tinyfpga/TinyFPGA-BX/TinyFPGA BX Card Back.png

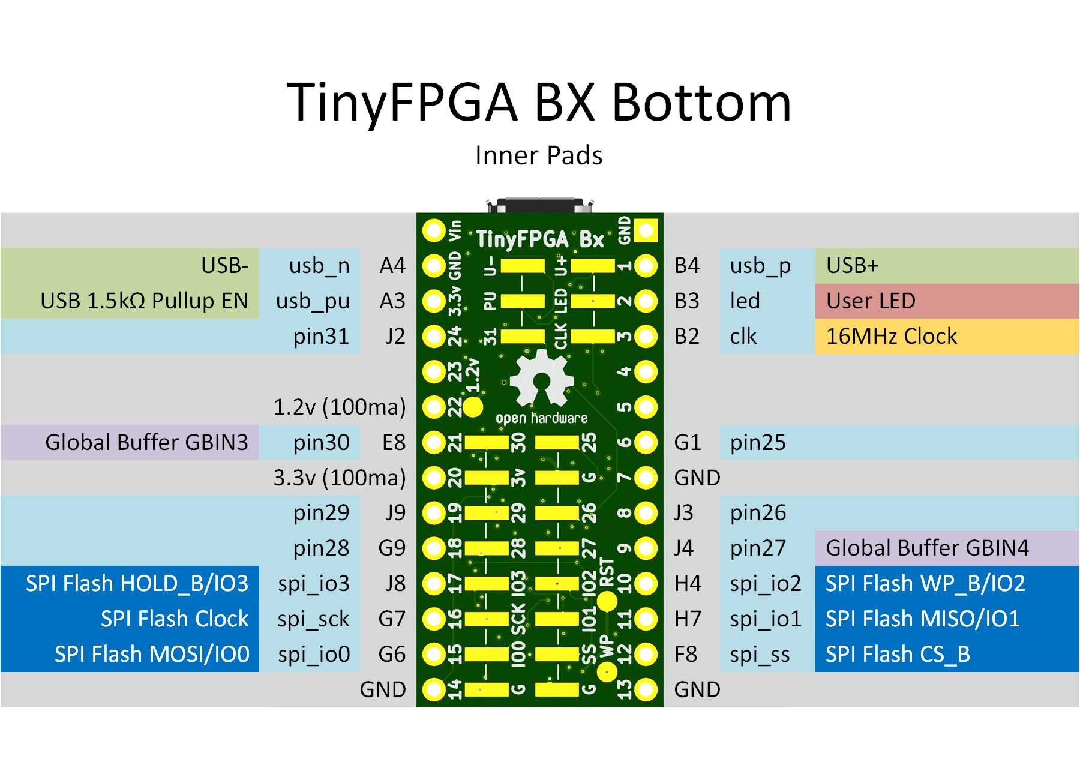
TinyFPGA BX Card Back.png
