tinyfpga/TinyFPGA-BX/TinyFPGA BX Card Front.png

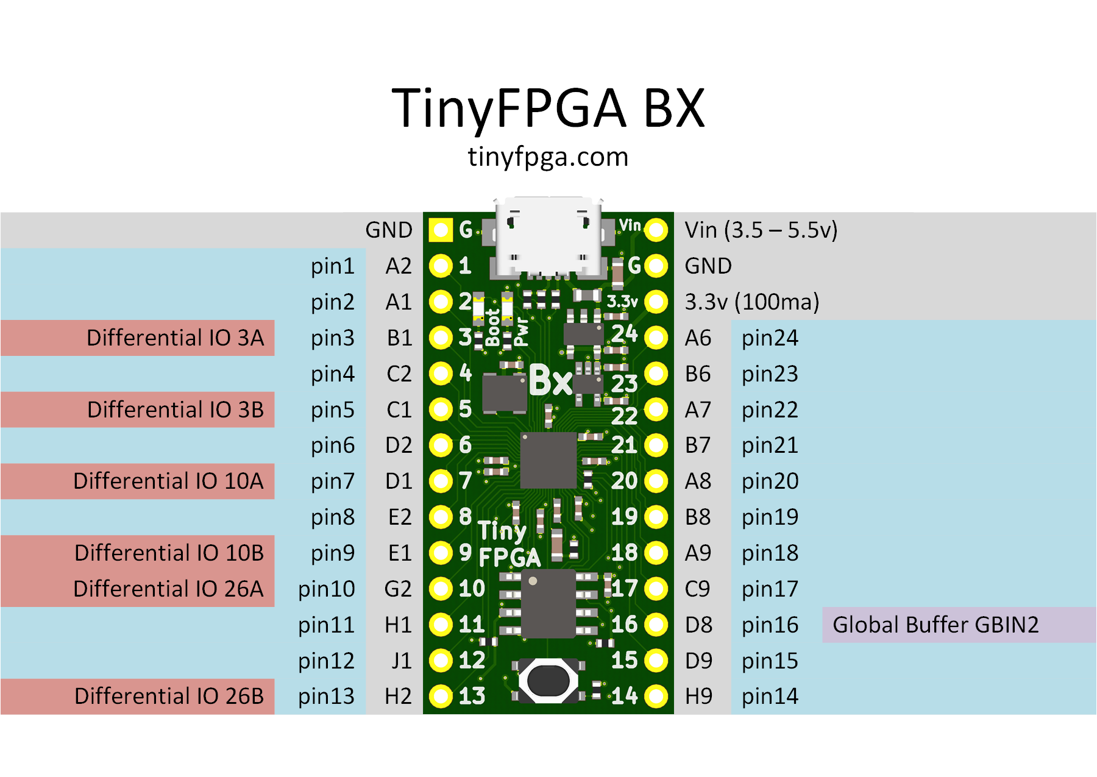
TinyFPGA BX Card Front.png
