tinyfpga/TinyFPGA-BX/(threads)

Thread 2 (2018-07-14):

Error: the JSON object must be str, not 'bytes'

gudenau, 2018-07-14:
I followed the dirrections here to try and program a TinyFPGA BX that I just got and when I get to the upload step it errors with `Error: the JSON object must be str, not 'bytes'`. I guess this is some random Python issue?

What happened:
Uploading the example project errors out with `Error: the JSON object must be str, not 'bytes'`

What should happen:
The project should upload and the FPGA should run it.

Platform:
`uname -a` : `Linux DESKTOP-DEBIAN 4.9.0-6-amd64 #1 SMP Debian 4.9.88-1+deb9u1 (2018-05-07) x86_64 GNU/Linux`

Steps to reproduce: (or what I did)
`sudo apt-get install python3-pip`
`sudo pip3 install --upgrade --no-cache-dir apio==0.4.0b3 "tinyprog>=1.0.9"`
`apio install system scons icestorm iverilog` (since drivers does not exist)
`apio drivers --serial-enable`
`tinyprog --update-bootloader`
Download atom-amd64.deb
`sudo dpkg -i atom-amd64.deb`
Install `apio-ide` in atom.
`git clone https://github.com/tinyfpga/TinyFPGA-BX.git`
`cp TinyFPGA-BX/apio_template blink_project`
Open `blink_project` with `atom`.
Upload.
Error happens here.

tinyfpga, 2018-07-15:
What's the exact version of python are you using?

Update `tinyprog` to 1.0.10:

```shell
sudo pip3 install --upgrade --no-cache-dir "tinyprog>=1.0.10"
```

Now run `tinyprog -p bitstream_filename.bin` to program the bitstream generated by APIO and paste any error message you get.

gudenau, 2018-07-15:
Python 3.5.3, and would that be hardware.bin?

tinyfpga, 2018-07-15:
Yeah, it think it’s hardware.bin.

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

gudenau, 2018-07-15:
```
    TinyProg CLI
    ------------
    Using device id 1d50:6130
    Only one board with active bootloader, using it.
Traceback (most recent call last):
  File "/usr/local/lib/python3.5/dist-packages/serial/serialposix.py", line 265, in open
    self.fd = os.open(self.portstr, os.O_RDWR | os.O_NOCTTY | os.O_NONBLOCK)
PermissionError: [Errno 13] Permission denied: '/dev/ttyACM0'

During handling of the above exception, another exception occurred:

Traceback (most recent call last):
  File "/usr/local/bin/tinyprog", line 11, in <module>
    sys.exit(main())
  File "/usr/local/lib/python3.5/dist-packages/tinyprog/__main__.py", line 298, in main
    with serial.Serial(active_port, timeout=1.0, writeTimeout=1.0) as ser:
  File "/usr/local/lib/python3.5/dist-packages/serial/serialutil.py", line 240, in __init__
    self.open()
  File "/usr/local/lib/python3.5/dist-packages/serial/serialposix.py", line 268, in open
    raise SerialException(msg.errno, "could not open port {}: {}".format(self._port, msg))
serial.serialutil.SerialException: [Errno 13] could not open port /dev/ttyACM0: [Errno 13] Permission denied: '/dev/ttyACM0'
```

Going to have to make sure I am in the group for that I suppose.

gudenau, 2018-07-15:
```

    TinyProg CLI
    ------------
    Using device id 1d50:6130
    Only one board with active bootloader, using it.
    Programming /dev/ttyACM0 with hardware.bin
Traceback (most recent call last):
  File "/usr/local/bin/tinyprog", line 11, in <module>
    sys.exit(main())
  File "/usr/local/lib/python3.5/dist-packages/tinyprog/__main__.py", line 309, in main
    addr = fpga.meta.userimage_addr_range()[0]
  File "/usr/local/lib/python3.5/dist-packages/tinyprog/__init__.py", line 95, in userimage_addr_range
    return self._get_addr_range(u"userimage")
  File "/usr/local/lib/python3.5/dist-packages/tinyprog/__init__.py", line 101, in _get_addr_range
    addr_str = self.root[u"bootmeta"][u"addrmap"][name]
TypeError: 'NoneType' object is not subscriptable
```
And now it is this.

tinyfpga, 2018-07-15:
Ok, thanks! I’m going to see if I can reproduce this.

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

tinyfpga, 2018-07-15:
Can you run `tinyprog -m` and paste the result?

gudenau, 2018-07-15:
```
Traceback (most recent call last):
  File "/usr/local/bin/tinyprog", line 11, in <module>
    sys.exit(main())
  File "/usr/local/lib/python3.5/dist-packages/tinyprog/__main__.py", line 229, in main
    m["port"] = port
TypeError: 'NoneType' object does not support item assignment
```

gudenau, 2018-07-15:
I wonder if it is because Python 3 is called `python3` and not `python`.

tinyfpga, 2018-07-15:
Ok, I wrote a script to help debug what's going on.  It will dump out the raw metadata from your board and attempt to parse it in json.  Any Python stack traces will be dumped out as well.

First, you'll need to install the `hexdump` python module:

```
pip install hexdump
```

Then you'll need to save the `raw_meta_dump.py` file I've attached and run it with python:

[raw_meta_dump.zip](https://github.com/tinyfpga/TinyFPGA-BX/files/2196119/raw_meta_dump.zip)

```
python3 raw_meta_dump.py
```

tinyfpga, 2018-07-15:
You might need to use `sudo pip3 install hexdump`

gudenau, 2018-07-15:
```
['/dev/ttyACM0']
Raw metadata:

1
00000000: 7B 22 62 6F 61 72 64 6D  65 74 61 22 3A 7B 22 6E  {"boardmeta":{"n
00000010: 61 6D 65 22 3A 22 54 69  6E 79 46 50 47 41 20 42  ame":"TinyFPGA B
00000020: 58 22 2C 22 66 70 67 61  22 3A 22 69 63 65 34 30  X","fpga":"ice40
00000030: 6C 70 38 6B 2D 63 6D 38  31 22 2C 22 68 76 65 72  lp8k-cm81","hver
00000040: 22 3A 22 31 2E 30 2E 30  22 2C 22 75 75 69 64 22  ":"1.0.0","uuid"
00000050: 3A 22 XX XX XX XX XX XX  XX XX XX XX XX XX XX XX  :"XXXXXXXX-XXXX-
00000060: XX XX XX XX XX XX XX XX  XX XX XX XX XX XX XX XX  XXXX-XXXX-XXXXXX
00000070: XX XX XX XX XX XX 22 7D  7D 00 20 20 20 20 20 20  XXXXXX"}}.
00000080: 20 20 20 20 20 20 20 20  20 20 20 20 20 20 20 20          
00000090: 20 20 20 20 20 20 20 20  20 20 20 20 20 20 20 20          
000000A0: 20 20 20 20 20 20 20 20  20 20 20 20 20 20 20 20          
000000B0: 20 20 20 20 20 20 20 20  20 20 20 20 20 20 20 20          
000000C0: 20 20 20 20 20 20 20 20  20 20 20 20 20 20 20 20          
000000D0: 20 20 20 20 20 20 20 20  20 20 20 20 20 20 20 20          
000000E0: 20 20 20 20 20 20 20 20  20 20 20 20 20 20 20 20          
000000F0: 20 20 20 20 20 20 20 20  20 20 20 20 20 20 20            

2
00000000: 7B 22 62 6F 6F 74 6D 65  74 61 22 3A 7B 22 62 6F  {"bootmeta":{"bo
00000010: 6F 74 6C 6F 61 64 65 72  22 3A 22 54 69 6E 79 46  otloader":"TinyF
00000020: 50 47 41 20 55 53 42 20  42 6F 6F 74 6C 6F 61 64  PGA USB Bootload
00000030: 65 72 22 2C 22 62 76 65  72 22 3A 22 31 2E 30 2E  er","bver":"1.0.
00000040: 31 22 2C 22 75 70 64 61  74 65 22 3A 22 68 74 74  1","update":"htt
00000050: 70 73 3A 2F 2F 74 69 6E  79 66 70 67 61 2E 63 6F  ps://tinyfpga.co
00000060: 6D 2F 75 70 64 61 74 65  2F 74 69 6E 79 66 70 67  m/update/tinyfpg
00000070: 61 2D 62 78 22 2C 22 61  64 64 72 6D 61 70 22 3A  a-bx","addrmap":
00000080: 7B 22 62 6F 6F 74 6C 6F  61 64 65 72 22 3A 22 30  {"bootloader":"0
00000090: 78 30 30 30 61 30 2D 30  78 32 38 30 30 30 22 2C  x000a0-0x28000",
000000A0: 22 75 73 65 72 69 6D 61  67 65 22 3A 22 30 78 32  "userimage":"0x2
000000B0: 38 30 30 30 2D 30 78 35  30 30 30 30 22 2C 22 75  8000-0x50000","u
000000C0: 73 65 72 64 61 74 61 22  3A 22 30 78 35 30 30 30  serdata":"0x5000
000000D0: 30 2D 30 78 31 30 30 30  30 30 22 7D 7D 7D 00 20  0-0x100000"}}}.
000000E0: 20 20 20 20 20 20 20 20  20 20 20 20 20 20 20 20          
000000F0: 20 20 20 20 20 20 20 20  20 20 20 20 20 20 20            

3
00000000: FF FF FF FF FF FF FF FF  FF FF FF FF FF FF FF FF  ................
00000010: FF FF FF FF FF FF FF FF  FF FF FF FF FF FF FF FF  ................
00000020: FF FF FF FF FF FF FF FF  FF FF FF FF FF FF FF FF  ................
00000030: FF FF FF FF FF FF FF FF  FF FF FF FF FF FF FF FF  ................
00000040: FF FF FF FF FF FF FF FF  FF FF FF FF FF FF FF FF  ................
00000050: FF FF FF FF FF FF FF FF  FF FF FF FF FF FF FF FF  ................
00000060: FF FF FF FF FF FF FF FF  FF FF FF FF FF FF FF FF  ................
00000070: FF FF FF FF FF FF FF FF  FF FF FF FF FF FF FF FF  ................
00000080: FF FF FF FF FF FF FF FF  FF FF FF FF FF FF FF FF  ................
00000090: FF FF FF FF FF FF FF FF  FF FF FF FF FF FF FF FF  ................
000000A0: FF FF FF FF FF FF FF FF  FF FF FF FF FF FF FF FF  ................
000000B0: FF FF FF FF FF FF FF FF  FF FF FF FF FF FF FF FF  ................
000000C0: FF FF FF FF FF FF FF FF  FF FF FF FF FF FF FF FF  ................
000000D0: FF FF FF FF FF FF FF FF  FF FF FF FF FF FF FF FF  ................
000000E0: FF FF FF FF FF FF FF FF  FF FF FF FF FF FF FF FF  ................
000000F0: FF FF FF FF FF FF FF FF  FF FF FF FF FF FF FF     ...............
Attempting to parse to JSON:

1
Traceback (most recent call last):
  File "raw_meta_dump.py", line 42, in <module>
    meta = json.loads(security_register.replace(b"\x00", b"").replace(b"\xff", b""))
  File "/usr/lib/python3.5/json/__init__.py", line 312, in loads
    s.__class__.__name__))
TypeError: the JSON object must be str, not 'bytes'
```

The JSON looks fairly okay to me.

tinyfpga, 2018-07-15:
Ok, I'm going to try converting the data to unicode.  Try the updated script I'm attaching and send back the output.  If this updated script works on your machine as it does on mine, then I'll be making a `tinyprog` update with a fix shortly.

[raw_meta_dump_unicode.zip](https://github.com/tinyfpga/TinyFPGA-BX/files/2196131/raw_meta_dump_unicode.zip)

gudenau, 2018-07-16:
I did X that out, since it is a UUID.

```
--snip--
Attempting to parse to JSON:

1
{
  "boardmeta": {
    "uuid": "XXXXXXXX-XXXX-XXXX-XXXX-XXXXXXXXXXXX",
    "hver": "1.0.0",
    "name": "TinyFPGA BX",
    "fpga": "ice40lp8k-cm81"
  }
}

2
{
  "bootmeta": {
    "update": "https://tinyfpga.com/update/tinyfpga-bx",
    "addrmap": {
      "userimage": "0x28000-0x50000",
      "bootloader": "0x000a0-0x28000",
      "userdata": "0x50000-0x100000"
    },
    "bootloader": "TinyFPGA USB Bootloader",
    "bver": "1.0.1"
  }
}

3
Traceback (most recent call last):
  File "raw_meta_dump_unicode.py", line 42, in <module>
    meta = json.loads(bytes(security_register.replace(b"\x00", b"").replace(b"\xff", b"")).decode("utf-8"))
  File "/usr/lib/python3.5/json/__init__.py", line 319, in loads
    return _default_decoder.decode(s)
  File "/usr/lib/python3.5/json/decoder.py", line 339, in decode
    obj, end = self.raw_decode(s, idx=_w(s, 0).end())
  File "/usr/lib/python3.5/json/decoder.py", line 357, in raw_decode
    raise JSONDecodeError("Expecting value", s, err.value) from None
json.decoder.JSONDecodeError: Expecting value: line 1 column 1 (char 0)
```

tinyfpga, 2018-07-16:
Great.  Try out the latest `tinyprog` release:

```
pip install --upgrade --no-cache-dir "tinyprog>=1.0.11"
```

tinyfpga, 2018-07-16:
It's extremely unlikely that the python executable name is affecting the outcome.  Can you copy the exact output of the following commands?

```
pip install --upgrade --no-cache-dir "tinyprog>=1.0.11"
tinyprog -l
```

gudenau, 2018-07-16:
```
gudenau@DESKTOP-DEBIAN:~$ pip install --upgrade --no-cache-dir "tinyprog>=1.0.11"
bash: pip: command not found
gudenau@DESKTOP-DEBIAN:~$ tinyprog -l

    TinyProg CLI
    ------------
    Using device id 1d50:6130
    Only one board with active bootloader, using it.
    Boards with active bootloaders:

        /dev/ttyACM0: TinyFPGA BX 1.0.0
            UUID: 57c8ba7b-6f2b-4d7b-879b-4127a8c95fcd
            FPGA: ice40lp8k-cm81
gudenau@DESKTOP-DEBIAN:~$
```

tinyfpga, 2018-07-16:
That's actually great.  It fixed the original problem of parsing the JSON.

Let's try splitting apart the tasks so we can identify where the issue is if there still is one.  Go to the project directory and build it with APIO:

```
apio build
```

Now try to update the `hardware.bin` file created by APIO directly using `tinyprog`:

```
tinyprog -p hardware.bin
```

That should work.  If it does work, then you can try uploading with APIO:

```
apio upload
```

gudenau, 2018-07-16:
```
gudenau@DESKTOP-DEBIAN:~/fpga/blink_project$ apio build
[Mon Jul 16 13:16:13 2018] Processing TinyFPGA-BX
--------------------------------------------------------------------------------
========================= [SUCCESS] Took 0.38 seconds =========================
gudenau@DESKTOP-DEBIAN:~/fpga/blink_project$ tinyprog -p hardware.bin

    TinyProg CLI
    ------------
    Using device id 1d50:6130
    Only one board with active bootloader, using it.
    Programming /dev/ttyACM0 with hardware.bin
    Programming at addr 028000
    Waking up SPI flash
    135100 bytes to program
    Erasing: 100%|████████████████████████████| 135k/135k [00:01<00:00, 111kB/s]
    Writing: 100%|████████████████████████████| 135k/135k [00:00<00:00, 167kB/s]
    Reading: 100%|████████████████████████████| 135k/135k [00:00<00:00, 493kB/s]
    Success!
gudenau@DESKTOP-DEBIAN:~/fpga/blink_project$ apio upload
Error: board TinyFPGA-BX not connected
gudenau@DESKTOP-DEBIAN:~/fpga/blink_project$ apio upload
Error: the JSON object must be str, not 'bytes'
gudenau@DESKTOP-DEBIAN:~/fpga/blink_project$
```
With colors of course, but I don't think markup supports that.

tinyfpga, 2018-07-16:
Ok, so you are able to program the TinyFPGA board successfully then.

After you program the board, the bootloader is no longer active, your user program is running.  In order to program the board again you have to press the reset button.

Now the fact that APIO update still reports an error is interesting.  Could be an APIO bug and unrelated to `tinyprog`.

gudenau, 2018-07-16:
It does look like it is calling Python 3 based on the syscalls it is making. Guess I should go find their issue tracker and link here?

gudenau, 2018-07-16:
FPGAwars/apio#159

ewenmcneill, 2018-07-22:
FTR, per https://github.com/FPGAwars/apio/issues/159#issuecomment-406840154 I think the issue is that there's code in *only* the `apio upload` functionality that is not Python 3 compatible; the same thing works fine with Python 2.  (It seems to me most/all of the rest of `apio` is already Python 3 compatible, so this looks like an oversight.)  So hopefully fixed fairly soon.  Meanwhile "use Python 2.7" is probably a useful work around for affected users.

Ewen

ewenmcneill, 2018-07-22:
On further investigation (https://github.com/FPGAwars/apio/issues/159#issuecomment-406841647) it appears only Python 3.0 - Python 3.5 will be affected; Python 2.7 defaults to `str`/`bytes` conversion, and Python 3.6+ [contains a compatibility fix in `json.loads()`](https://docs.python.org/3/library/json.html#basic-usage) so it will accept `bytes`.

Ewen

Thread 3 (2018-07-16):

icecube2_template lacks `top.v`

MartyMacGyver, 2018-07-16:
The apio and icestorm template projects each contain an example `top.v`, but `icecube2_template` doesn't. For consistency it ought to.

rtolesnikov, 2018-08-26:
FWIT, there are several issues with icecube2 template. I've created a pull request https://github.com/tinyfpga/TinyFPGA-BX/pull/10 that fixes this issue and all others I've encountered.

RRob777, 2021-03-13:
Salut.
J'ai trouvé la solution.
J'utilise iCEcube2 (de Lattice) pour concevoir le code VHDL et configurer les broches utilisées (ordre, layout, pull-up ...). iCEcube2 me fournit alors un fichier binaire (.bin).
J'ai pensé utiliser le logiciel TinyFPGA-Programmer mais il y a un problème avec celui-ci (comme expliqué ci-dessus).

-> 1. La solution pour programmer le Tiny FPGA BX est de suivre attentivement les instructions de ce site en s'arrêtant au point 3 (avant de télécharger Atom):

Guide de l'utilisateur TinyFPGA BX: https://tinyfpga.com/bx/guide.html

* Si vous rencontrez des problèmes lors de l'installation des modules (Apio, tinyprog ...) n'hésitez pas à taper votre message d'erreur (qui apparaissait sur l'invite de commande Windows) sur google. Il existe souvent des forums qui ont résolu des problèmes.
** J'ai rencontré ce problème: aucun module nommé pyrsistent.
Écrivez dans l'invite de commande Windows (cmd): pip install "pyrsistent == 0.15.7"

Suivez ensuite les instructions sur ce site à partir du point 13 et arrêtez-vous après avoir fait le point 16:
https://www.centennialsoftwaresolutions.com/post/install-remove-tools-for-tinyfpga-bx-programming-and-program-the-board-on-windows-7-sp1

Et là, si tout s'est bien passé, vous avez programmé votre Tiny FPGA BX.
Cette méthode vous permet de programmer votre Tiny FPGA BX avec l'invite de commande Windows (à partir d'un fichier binare (.bin)).
Pour information, je suis sous Windows 10.

RRob777, 2021-03-13:
To reprogram your Tiny FPGA BX the next time, repeat step 2 after generating your binary file (.bin).

Thread 4 (2018-07-24):

Serial port difficulties with Linux, with possible solution

DavidAntliff, 2018-07-24:
When I connect the board (with supplied firmware) to Ubuntu 16.04 via USB I see this in my Linux kernel log:
```
[2157524.597052] usb 1-1: new full-speed USB device number 40 using xhci_hcd
[2157524.737724] usb 1-1: New USB device found, idVendor=1209, idProduct=2100
[2157524.737730] usb 1-1: New USB device strings: Mfr=0, Product=0, SerialNumber=0
[2157524.738464] cdc_acm 1-1:1.0: ttyACM0: USB ACM device
[2157536.029885] cdc_acm 1-1:1.1: urb 2 failed submission with -19
[2157536.029905] usb 1-1: USB disconnect, device number 40
[2157536.029919] cdc_acm 1-1:1.1: urb 3 failed submission with -19
[2157536.029956] cdc_acm 1-1:1.1: urb 4 failed submission with -19
[2157536.029996] cdc_acm 1-1:1.1: urb 5 failed submission with -19
[2157536.030036] cdc_acm 1-1:1.1: urb 6 failed submission with -19
[2157536.030077] cdc_acm 1-1:1.1: urb 7 failed submission with -19
[2157536.030118] cdc_acm 1-1:1.1: urb 8 failed submission with -19
[2157536.030140] cdc_acm 1-1:1.0: failed to set dtr/rts
[2157536.030160] cdc_acm 1-1:1.1: urb 9 failed submission with -19
[2157536.030199] cdc_acm 1-1:1.1: urb 10 failed submission with -19
[2157536.436674] usb 1-1: new full-speed USB device number 41 using xhci_hcd
[2157536.577210] usb 1-1: New USB device found, idVendor=1209, idProduct=2100
[2157536.577216] usb 1-1: New USB device strings: Mfr=0, Product=0, SerialNumber=0
[2157536.577957] cdc_acm 1-1:1.0: ttyACM0: USB ACM device
```
This sort of thing appears every few seconds in the `dmesg` log.

Running `tinyprog -m` results in one of three different results:

```
$ tinyprog -m
[
  {
    "boardmeta": {
      "name": "TinyFPGA BX",
      "fpga": "ice40lp8k-cm81",
      "hver": "1.0.0",
      "uuid": "03cfce7b-b1d9-467a-a05e-1a08839f1786"
    },
    "bootmeta": {
      "bootloader": "TinyFPGA USB Bootloader",
      "bver": "1.0.1",
      "update": "https://tinyfpga.com/update/tinyfpga-bx",
      "addrmap": {
        "bootloader": "0x000a0-0x28000",
        "userimage": "0x28000-0x50000",
        "userdata": "0x50000-0x100000"
      }
    },
    "port": "/dev/ttyACM0"
  }
]
```
Or:
```
$ tinyprog -m
Traceback (most recent call last):
  File "/home/dantliff/.pyenv/versions/3.6.5/envs/tinyfpga-3.6.5/lib/python3.6/site-packages/serial/serialposix.py", line 265, in open
    self.fd = os.open(self.portstr, os.O_RDWR | os.O_NOCTTY | os.O_NONBLOCK)
OSError: [Errno 16] Device or resource busy: '/dev/ttyACM0'

During handling of the above exception, another exception occurred:

Traceback (most recent call last):
  File "/home/dantliff/.pyenv/versions/tinyfpga-3.6.5/bin/tinyprog", line 11, in <module>
    sys.exit(main())
  File "/home/dantliff/.pyenv/versions/3.6.5/envs/tinyfpga-3.6.5/lib/python3.6/site-packages/tinyprog/__main__.py", line 226, in main
    with serial.Serial(port, timeout=1.0, writeTimeout=1.0) as ser:
  File "/home/dantliff/.pyenv/versions/3.6.5/envs/tinyfpga-3.6.5/lib/python3.6/site-packages/serial/serialutil.py", line 240, in __init__
    self.open()
  File "/home/dantliff/.pyenv/versions/3.6.5/envs/tinyfpga-3.6.5/lib/python3.6/site-packages/serial/serialposix.py", line 268, in open
    raise SerialException(msg.errno, "could not open port {}: {}".format(self._port, msg))
serial.serialutil.SerialException: [Errno 16] could not open port /dev/ttyACM0: [Errno 16] Device or resource busy: '/dev/ttyACM0'
```
Or:
$ tinyprog -m
[]

After creating the following file:
```
$ cat /etc/udev/rules.d/90-tinyfpga-bx.rules
ATTRS{idVendor}=="1209", ATTRS{idProduct}=="2100",
ENV{ID_MM_DEVICE_IGNORE}="1"
ATTRS{idVendor}=="1209", ATTRS{idProduct}=="2100",
ENV{MTP_NO_PROBE}="1"
```
Then `sudo udevadm control --reload`, `dmesg` settles down with just:

```
[2157750.872236] usb 1-1: USB disconnect, device number 56
[2157751.277717] usb 1-1: new full-speed USB device number 57 using xhci_hcd
[2157751.418324] usb 1-1: New USB device found, idVendor=1209, idProduct=2100
[2157751.418330] usb 1-1: New USB device strings: Mfr=0, Product=0, SerialNumber=0
[2157751.419205] cdc_acm 1-1:1.0: ttyACM0: USB ACM device
```
Now `tinyprog -m` produces consistent and reproducible output:

```
$ tinyprog -m
[
  {
    "boardmeta": {
      "name": "TinyFPGA BX",
      "fpga": "ice40lp8k-cm81",
      "hver": "1.0.0",
      "uuid": "03cfce7b-b1d9-467a-a05e-1a08839f1786"
    },
    "bootmeta": {
      "bootloader": "TinyFPGA USB Bootloader",
      "bver": "1.0.1",
      "update": "https://tinyfpga.com/update/tinyfpga-bx",
      "addrmap": {
        "bootloader": "0x000a0-0x28000",
        "userimage": "0x28000-0x50000",
        "userdata": "0x50000-0x100000"
      }
    },
    "port": "/dev/ttyACM0"
  }
]
```

DavidAntliff, 2018-07-24:
Turns out that the [User Guide](https://tinyfpga.com/bx/guide.html) has a step that does all this for you: `apio drivers --serial-enable`, creates:

MCDELTAT, 2019-03-11:
Confirmed as a fix for me on Lint Mint 19.1 (Ubuntu 18.04) as well.

paulo-raca, 2019-07-05:
I faced the same issue on Ubuntu 19.04 -- It crashes and re-enumerates every few seconds:
```
[ 1563.376825] usb 1-9: USB disconnect, device number 92
[ 1563.377078] cdc_acm 1-9:1.0: failed to set dtr/rts
[ 1563.797511] usb 1-9: new full-speed USB device number 93 using xhci_hcd
[ 1563.954415] usb 1-9: New USB device found, idVendor=1209, idProduct=2100, bcdDevice= 0.00
[ 1563.954423] usb 1-9: New USB device strings: Mfr=0, Product=0, SerialNumber=0
[ 1563.956735] cdc_acm 1-9:1.0: ttyACM1: USB ACM device
```

I've tried `apio drivers --serial-enable` and manually setting `ENV{ID_MM_DEVICE_IGNORE}="1"`/`ENV{MTP_NO_PROBE}="1"` without luck.

Assuming something else is trying to use the port (Since tinyprog says "Device Busy"), I tried changing it's permissions so that system services couldn't access it:

```
ATTRS{idVendor}=="1209", ATTRS{idProduct}=="2100", OWNER="paulo", GROUP="paulo"
OWNER="paulo", GROUP="paulo"
```

Surprisingly, this worked for me, but I guess there must be a better solution ;)

pamdemonia, 2019-10-08:
I know this is closed, but thank you for this! It was the only thing that worked for me!

I'm on Ubuntu 19.04 for any searchers to come.

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

paulo-raca, 2019-10-08:
I'm glad it was helpful :)

DaveMcEwan, 2019-11-23:
I had this same problem on Ubuntu18.04. It looked like ModemManager wouldn't stop trying to use the device, despite the udev rules.
Just removing it completely with `sudo apt-get purge modemmanager` solved the problem and allowed consistent use of tinyprog.

SamWibatt, 2020-01-09:
sudo apt purge modemmanager worked for me, too (Ubuntu 18.04). Thank you very much, DaveMcEwan!

kvrineet26, 2020-03-06:
removing modemmanager worked for me. I am also unit Ubuntu 18.04. Thanks Dave.

HHelmius, 2020-06-05:
Thank you so much DaveMcEwan! This solved a similar issue with an Arduino Nano I was trying to get working.

Thread 12 (2018-09-17):

add USB serial UART to picosoc example

mattvenn, 2018-09-17:
It would be great to wire the USB serial we have for the bootloader to the tx/rx pins. That way an external USB serial wouldn't be needed.

I will take a look but might need some help.

korkies22, 2019-09-21:
I would like an example of this too...

DavidGoedicke, 2023-03-22:
Yes I really need Serial access over USB.

Thread 13 (2018-09-17):

picosoc example linker script problems

mattvenn, 2018-09-17:
If you checkout the ws2812 branch of my fork here: https://github.com/mattvenn/TinyFPGA-BX/tree/ws2812
And then simulate:

make sim

You will see serial output and then gtkwave will start. At 359us, the LED register is written.
This also works on the hardware.

Example 1:
Global variables are unintialised.

In firmware.c, #define BREAK1

make sim

Serial never gets beyond the Booting, and at 305us the LED register is written with XXXXXX

Example 2:
Can't program tinyfpga.

In firmware.c #define BREAK2

make sim

simulates correctly, but tinyfpga fails to program:
```
matt-pc:2216 [ws2812]: make
tinyprog -p hardware.bin -u firmware.bin
/home/matt/.local/lib/python2.7/site-packages/requests/__init__.py:83: RequestsDependencyWarning: Old version of cryptography ([1, 2, 3]) may cause slowdown.
  warnings.warn(warning, RequestsDependencyWarning)

    TinyProg CLI
    ------------
    Using device id 1d50:6130
    Only one board with active bootloader, using it.
    Programming /dev/ttyACM1 with hardware.bin
    Programming at addr 028000
    Waking up SPI flash
    135100 bytes to program
    Erasing: 100%|██████████████████████████████████████████████████████████████████████████████████████████████████████████████████████████████████████████████████████████████████████████████████████████████████████| 135k/135k [00:00<00:00, 138kB/s]
    Writing: 100%|██████████████████████████████████████████████████████████████████████████████████████████████████████████████████████████████████████████████████████████████████████████████████████████████████████| 135k/135k [00:00<00:00, 177kB/s]
    Reading: 100%|██████████████████████████████████████████████████████████████████████████████████████████████████████████████████████████████████████████████████████████████████████████████████████████████████████| 135k/135k [00:00<00:00, 430kB/s]
    Success!
    Programming /dev/ttyACM1 with firmware.bin
    Programming at addr 050000
    Waking up SPI flash
    3616 bytes to program
    Erasing: 100%|███████████████████████████████████████████████████████████████████████████████████████████████████████████████████████████████████████████████████████████████████████████████████████████████████| 3.62k/3.62k [00:01<00:00, 3.42kB/s]
    Writing: 100%|████████████████████████████████████████████████████████████████████████████████████████████████████████████████████████████████████████████████████████████████████████████████████████████████████| 3.62k/3.62k [00:00<00:00, 115kB/s]
    Reading: 100%|████████████████████████████████████████████████████████████████████████████████████████████████████████████████████████████████████████████████████████████████████████████████████████████████████| 3.62k/3.62k [00:00<00:00, 234kB/s]
    Failure!
Makefile:3: recipe for target 'upload' failed
make: *** [upload] Error 1
```

ruabmbua, 2019-05-15:
I have the same problem. I managed to debug it. Seems like my flash got corrupted on address 0x050000. The readout is not equal to the written image...
I will try to send the board back to the seller, and get a new one in exchange.
Otherwise the tinyfpga was an amazing experience.

Has someone else had similar problems?

mattvenn, 2019-05-16:
I forgot about this issue after I resolved it by changing the linker script. See this commit: https://github.com/mattvenn/TinyFPGA-BX/commit/b5d2e848f4e9dd0e0beb1729d488813bea5d6ca6

Closed 2019-05-16.

Thread 18 (2019-06-04):

Clock Not Connected to a global net pin

zignig, 2019-06-04:
Maybe for BX mark III ?

https://github.com/m-labs/nmigen/issues/82

rjeschmi, 2019-07-14:
There is some discussion here that are relevant: https://discourse.tinyfpga.com/t/tinyfpga-based-on-ice40-up5k-sg48/615

Closed 2020-07-10.

Thread 20 (2019-07-31):

Program not loaded when powered from dumb power supply until reset button pressed

yodaldevoid, 2019-07-31:
I have found that when powering the TinyFPGA-BX from a "dumb" power supply the bootloader does not start and therefore the last loaded program is not loaded until the reset button is pressed.

tinyprog shows the board with a 1.0.0 bootloader, and says that the bootloader is at the newest version.

reubenstr, 2020-12-07:
I had the same issue when powering a TinyFPGA Bx with 3.3v directly to the 3.3v pin. After removing 3.3v to the 3.3v pin and applying 3.3v to the VIN pin the TinyFPGA booted upon power up as expected.

Thread 24 (2020-04-18):

Error: board TinyFPGA-BX not connected

Luca8991, 2020-04-18:
I'm getting this error after `Apio: Upload` from Atom.
The bootloader board keeps going offline (LED stops blinking).

Here's the log from `$ dmesg`:

```
[ 2443.927967] cdc_acm 2-3:1.0: failed to set dtr/rts
[ 2493.381379] debugfs: Directory '09' with parent 'devices' already present!
[ 2493.993317] usb 2-3: new full-speed USB device number 74 using xhci_hcd
[ 2494.142205] usb 2-3: New USB device found, idVendor=1d50, idProduct=6130, bcdDevice= 0.00
[ 2494.142207] usb 2-3: New USB device strings: Mfr=0, Product=0, SerialNumber=0
[ 2494.143308] cdc_acm 2-3:1.0: ttyACM0: USB ACM device
[ 2513.926778] usb 2-3: USB disconnect, device number 74
[ 2513.926877] cdc_acm 2-3:1.0: failed to set dtr/rts
[ 3235.189611] debugfs: Directory '10' with parent 'devices' already present!
[ 3235.317550] usb 2-3: new full-speed USB device number 75 using xhci_hcd
[ 3342.172788] debugfs: Directory '11' with parent 'devices' already present!
[ 3342.300710] usb 2-3: new full-speed USB device number 76 using xhci_hcd
[ 3342.428783] usb 2-3: device descriptor read/64, error -71
[ 3342.664732] usb 2-3: device descriptor read/64, error -71
[ 3342.772749] debugfs: Directory '12' with parent 'devices' already present!
[ 3342.900722] usb 2-3: new full-speed USB device number 77 using xhci_hcd
[ 3343.028718] usb 2-3: device descriptor read/64, error -71
[ 3343.264737] usb 2-3: device descriptor read/64, error -71
[ 3343.372749] usb usb2-port3: attempt power cycle
[ 3343.688729] debugfs: Directory '13' with parent 'devices' already present!
[ 3344.232697] usb 2-3: new full-speed USB device number 78 using xhci_hcd
[ 3344.253218] usb 2-3: New USB device found, idVendor=1d50, idProduct=6130, bcdDevice= 0.00
[ 3344.253221] usb 2-3: New USB device strings: Mfr=0, Product=0, SerialNumber=0
[ 3344.254320] cdc_acm 2-3:1.0: ttyACM0: USB ACM device
[ 3363.918157] usb 2-3: USB disconnect, device number 78
[ 3363.918302] cdc_acm 2-3:1.0: failed to set dtr/rts
[ 3449.699880] usb 2-3: new full-speed USB device number 79 using xhci_hcd
```

Thread 25 (2020-04-24):

No BOM file in the Board folder

lurenaud, 2020-04-24:
Hello,
I'm currently trying to make my own board. However I cannot find the BOM that you mention in the readme. Could you add it ?
Thanks in advance

lurenaud, 2020-05-06:
The link was in description.... shame on me
https://octopart.com/bom-tool/ALrZVouf

Closed 2020-05-06.

Thread 29 (2020-08-10):

Cables are IMPORTANT!

AGenews, 2020-08-10:
I've played now some time to setup the programming environment on my Linux PC and nothing worked till I changed the cable.
I was using a Sparkfun cable [https://www.sparkfun.com/products/12016](url) which usually works very good for all my Arduino stuff but I suspect in somewho interferes with a RESET (?) .. I dunno. Once I'v replaced that cable ATOM/apio found the board and I could uploed the _blink_ sketch.
Best,
A.

Thread 33 (2021-11-14):

Problem updating the bootloader on a TinyFPGA-BX

wombatbutt, 2021-11-14:
I have a TinyFPGA BX board that is connected to a Mac (Big Sur) I am trying to upload a new bootloader to this board using tinyprog (https://pypi.org/project/tinyprog/). I am running this with

  ```
>>>from tinyprog import *
  >>>from tinyprog.__main__ import perform_bootloader_update
  >>>tinyport=get_ports('1d50:6130')
  >>>perform_bootloader_update(tinyport[0])

```

The result of this is:

```

    The following update:

        New Version: 1.0.1
        Notes: Updates USB VID:PID to fix issues with APIO not recognizing the board.

    is available for this board:

        USB 20.3: TinyFPGA BX 1.0.0
            UUID: cfaef439-1b38-4576-b1bc-970b9f5d5ee1
            FPGA: ice40lp8k-cm81

    Would you like to perform the update? [y/N] y
    Fetching stage one...
    Programming stage one...

    Erasing: 100%|████████████████████████████| 135k/135k [00:00<00:00, 175kB/s]
    Writing: 100%|████████████████████████████| 135k/135k [00:00<00:00, 163kB/s]
    Reading: 100%|████████████████████████████| 135k/135k [00:00<00:00, 344kB/s]

---------------------------------------------------------------------------
USBError                                  Traceback (most recent call last)
/var/folders/n5/kk2vsh296_s0w454yrchd3f00000gn/T/ipykernel_13323/2827260816.py in <module>
----> 1 perform_bootloader_update(tinyport[0])

/opt/anaconda3/envs/verilogenv38/lib/python3.8/site-packages/tinyprog/__main__.py in perform_bootloader_update(port)
    149             userimage_addr = p.meta.userimage_addr_range()[0]
    150             if p.program_bitstream(userimage_addr, bitstream):
--> 151                 p.boot()
    152                 print("    ...Success!")
    153             else:

/opt/anaconda3/envs/verilogenv38/lib/python3.8/site-packages/tinyprog/__init__.py in boot(self)
    386     def boot(self):
    387         try:
--> 388             self.ser.write(b"\x00")
    389             self.ser.flush()
    390         except SerialTimeoutException as e:

/opt/anaconda3/envs/verilogenv38/lib/python3.8/site-packages/tinyprog/__init__.py in write(self, data)
     90
     91     def write(self, data):
---> 92         self.OUT.write(data)
     93
     94     def flush(self):

/opt/anaconda3/envs/verilogenv38/lib/python3.8/site-packages/usb/core.py in write(self, data, timeout)
    406         For details, see the Device.write() method.
    407         """
--> 408         return self.device.write(self, data, timeout)
    409
    410     def read(self, size_or_buffer, timeout = None):

/opt/anaconda3/envs/verilogenv38/lib/python3.8/site-packages/usb/core.py in write(self, endpoint, data, timeout)
    987         fn = fn_map[util.endpoint_type(ep.bmAttributes)]
    988
--> 989         return fn(
    990                 self._ctx.handle,
    991                 ep.bEndpointAddress,

/opt/anaconda3/envs/verilogenv38/lib/python3.8/site-packages/usb/backend/libusb1.py in bulk_write(self, dev_handle, ep, intf, data, timeout)
    835     @methodtrace(_logger)
    836     def bulk_write(self, dev_handle, ep, intf, data, timeout):
--> 837         return self.__write(self.lib.libusb_bulk_transfer,
    838                             dev_handle,
    839                             ep,

/opt/anaconda3/envs/verilogenv38/lib/python3.8/site-packages/usb/backend/libusb1.py in __write(self, fn, dev_handle, ep, intf, data, timeout)
    936         # do not assume LIBUSB_ERROR_TIMEOUT means no I/O.
    937         if not (transferred.value and retval == LIBUSB_ERROR_TIMEOUT):
--> 938             _check(retval)
    939
    940         return transferred.value

/opt/anaconda3/envs/verilogenv38/lib/python3.8/site-packages/usb/backend/libusb1.py in _check(ret)
    602             raise USBTimeoutError(_strerror(ret), ret, _libusb_errno[ret])
    603         else:
--> 604             raise USBError(_strerror(ret), ret, _libusb_errno[ret])
    605
    606     return ret

USBError: [Errno 5] Input/Output Error

```

My understanding of this is that the board is able to be updated but then tinyprog is trying to boot the board and this is failing. I am able to access this USB device just using pyusb but again when I try to write with ser.write in pyusb I get the same error.

Is this a problem with the board itself or is this the tinyprog not working properly?

bmentink, 2023-04-09:
I am having similar issues with tinyprog and macos. It seems that tinyprog serial rate over USB is too high for macos, especially on the M1 via DisplayPort adapters. It would be good if there could be an option to throttle the serial data rate, I think that would fix a lot of issues on macos.

(Other dev boards I have programmed on the M1 have needed to be throttled to 600Kbaud ..)

Thread 37 (2023-08-23):

Can't program, possibly no metadata on TinyFPGA BX just received ~ 2023-08-22

eyz, 2023-08-23:
```
$ pip3 list | grep tinyprog
tinyprog                           1.0.21
```

```
$ lsusb | grep 1d50
Bus 003 Device 021: ID 1d50:6130 OpenMoko, Inc.
```

```
$ make
tinyprog -p hardware.bin

    TinyProg CLI
    ------------
    Using device id 1d50:6130
    Only one board with active bootloader, using it.
    Programming /dev/ttyACM0 with hardware.bin
Traceback (most recent call last):
  File "/home/isaac/.local/bin/tinyprog", line 8, in <module>
    sys.exit(main())
  File "/home/isaac/.local/lib/python3.10/site-packages/tinyprog/__main__.py", line 334, in main
    addr = fpga.meta.userimage_addr_range()[0]
  File "/home/isaac/.local/lib/python3.10/site-packages/tinyprog/__init__.py", line 182, in userimage_addr_range
    return self._get_addr_range(u"userimage")
  File "/home/isaac/.local/lib/python3.10/site-packages/tinyprog/__init__.py", line 188, in _get_addr_range
    addr_str = self.root[u"bootmeta"][u"addrmap"][name]
TypeError: 'NoneType' object is not subscriptable
make: *** [Makefile:2: upload] Error 1
```

```
$ tinyprog -l

    TinyProg CLI
    ------------
    Using device id 1d50:6130
    Only one board with active bootloader, using it.
    Boards with active bootloaders:

        /dev/ttyACM0: No metadata
```

```
$ python3
Python 3.10.12 (main, Jun 11 2023, 05:26:28) [GCC 11.4.0] on linux
Type "help", "copyright", "credits" or "license" for more information.
>>>
```

drujensen, 2023-08-25:
@eyz Confirming that I am running into this same issue. Received this board from Crowd Supply today.  If you solve it, would be interested.

looking at the code:
```
class TinyProg(object):
    def __init__(self, ser, progress=None):
        ...

        # temporary hack, should have better database as well as SFPD reading
        if flash_id[0:2] == [0x9D, 0x60]:
            # ISSI
            self.security_page_bit_offset = 4
            self.security_page_write_cmd = 0x62
            self.security_page_read_cmd = 0x68
            self.security_page_erase_cmd = 0x64

        else:
            # Adesto
            self.security_page_bit_offset = 0
            self.security_page_write_cmd = 0x42
            self.security_page_read_cmd = 0x48
            self.security_page_erase_cmd = 0x44

        self.meta = TinyMeta(self)
```
Looks like these cmd are not working and meta is returning None.

eyz, 2023-08-25:
I would be very much willing to pay someone through a Patreon or Paypal if they sort this out. I have a project riding on this, as otherwise I'd have to send off my only production unit.

eyz, 2023-08-25:
> Looks like these cmd are not working and meta is returning None. Maybe our boards didn't come with the meta json included?

I suspect the bootloader is programmed (because tinyprog indicates it's there) but the metadata file wasn't uploaded. I wonder if it's a known issue for any of the boards produced. I ordered two more and would be overjoyed if they had the metadata on them, so I didn't have to figure out how to upload the metadata myself. That said, if it's super easy to connect some SPI up and use an Arduino sketch to upload the metadata I would be up for it.

eyz, 2023-08-25:
@tinyfpga is there another TinyFPGA BX production run that includes these metadata files?

drujensen, 2023-08-26:
@eyz I did a bit of hacking on the tinyprog project to bypass the meta check.  This is only a temporary solution and will  break your other fpga's if you do this.  You have been warned!

Find where tinyprog source code is at.  should be under `site-packages` and hard code the self.root in the `__init__.py` file as follows:
```
class TinyMeta(object):
    def __init__(self, prog):
        self.prog = prog
        prog.wake()
        self.root = {
            "boardmeta": {
                "hver": "0.0.0",
                "name": "TinyFPGA BX",
                "fpga": "ICE40LP8K-cm81",
                "uuid": "4a300a6f-895a-44d3-b021-356c6b38b339",
            },
            "bootmeta": {
                "bver": "2.0.0",
                "bootloader": "TinyFPGA USB Bootloader",
                "update": "https://tinyfpga.com/update/tinyfpga-bx",
                "addrmap": {
                    "bootloader": "0x00000-0x28000",
                    "userimage":  "0x28000-0x50000",
                    "userdata":   "0x50000-0xFC000",
                    "desc.tgz":   "0xFC000-0xFFFFF"
                }
            }
        }
```

If you want to be extra safe, copy or fork the project somewhere and then run this python script directly instead of using the one in the path. (Note: I generated a UUID to avoid conflicts)

eyz, 2023-08-26:
> @eyz I did a bit of hacking on the tinyprog project to bypass the meta check.

Nice! It looks like you are simply hard coding the expected metadata where it would normally be retrieved from the Tiny FPGA BX. Since I'm only using this one FPGA with tinyprog that's a completely acceptable solution. Great hack! If the USB ID is specific to the tiny FPGA BX maybe this could be a suitable workaround for others as well, such as if that USB ID is found it would simply drop this in if it couldn't be located, like a "use default metadata" flag.

eyz, 2023-08-26:
@tinyfpga Any chance you have a unique ID regarding the TinyFPGA BX boards that can do as we've done above in case the metadata is not found on the board? Perhaps the USB ID?

eyz, 2023-08-26:
I was successfully able to dump security pages 1, 2, and 3 to binary files from my older model TinyFPGA BX. However, when I tried to use this function to program them I saw no evidence of the security pages being updated, presumably because they are write-protected. I suspect there is some process to unlock the write-protection outside of tinyprog. Without this information I believe I cannot proceed further in correcting the security page metadata.

```python
    def program_security_register_page(self, page, data):
        self.write_enable()
        self.cmd(self.security_page_write_cmd, page << (8 + self.security_page_bit_offset), data)
        self.wait_while_busy()
```

Blackninja543, 2023-08-26:
@eyz According to https://github.com/tinyfpga/TinyFPGA-BX/blob/master/TinyFPGA%20BX%20Card%20Back.png pin 10 (H4|spi_io2|SPI Flash WP_B/IO2) looks like it might also be the same write protect pin.

eyz, 2023-08-26:
> @eyz According to https://github.com/tinyfpga/TinyFPGA-BX/blob/master/TinyFPGA%20BX%20Card%20Back.png pin 10 (H4|spi_io2|SPI Flash WP_B/IO2) looks like it might also be the same write protect pin.

I'm checking in the KiCad sketch now.

eyz, 2023-08-26:
> @eyz According to https://github.com/tinyfpga/TinyFPGA-BX/blob/master/TinyFPGA%20BX%20Card%20Back.png pin 10 (H4|spi_io2|SPI Flash WP_B/IO2) looks like it might also be the same write protect pin.

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

Yep. It looks like that net is pulled-up to 3.3 volts. Here's the KiCad board mirrored and rotated to the same orientation as the photo of the back of the board -

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

eyz, 2023-08-26:
I had no luck grounding WP when trying to update those areas, unless I didn't make a good electrical connection to ground over multiple attempts. I defer to others here.

Blackninja543, 2023-08-26:
After doing some more research it does appear the fix is going to be a little harder.

> SPI Flash Security Register Page 1 (write-protected)
One of the SPI flash security register pages contains fixed data about the board that does not change. This is the name of the board, the hardware revision of the board, and serial number unique to the board name. This security register page should be write protected as it should never be changed. If the rest of the SPI flash is erased, this minimal amount of information will help the user to find recovery instructions.

https://github.com/tinyfpga/TinyFPGA-Bootloader

eyz, 2023-08-26:
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

I'm deferring to those here to come up with a solution, or possibly return these units for replacements that are programmed properly.

eyz, 2023-09-14:
> I edited the **init** method as suggested and was able to program my board, but is there a way that I can program the needed metadata onto the board myself?

Based on my extensive research in the thread above, it's extremely unlikely that you can program the metadata into the security protected portion of the SPI flash. My findings was that it's most likely locked when they ship the board, and effectively read only in that area, thus you can't update it again.

drujensen, 2023-09-14:
We could hack a solution in this driver to handle the broken boards?

Maybe something like:  if the query to the metadata fails, use a default json file.

scm2000, 2023-09-14:
> Should hack a solution in this driver to handle the broken boards?
>
> Maybe something like: if the query to the metadata fails, use this default json file.

Right now this is the only board I'm working with... At some point if this isn't fixed in some way officially, I expect I'll do exactly that, --- if it can't get metadata, substitute in this metadata... quite a hack though.   but the state of the software is already such that I have to hack around anyway to get apio and tinyprog to work on a mac.

eyz, 2023-09-15:
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

It's really only a hack for the tool set that integrates between the metadata in the secure part of the flash and tinyprog though. It was clearly a design decision, and this is where it breaks down in case the secure area gets locked on the flash. patching the software side is not horrible considering.

I just got two more from Mouser a few days ago and I'll report back if they have the same issue.

Blackninja543, 2023-09-15:
I believe the only true fix to this issue is to de-solder the the flash, reprogram it, and solder it back in place.

eyz, 2023-09-15:
> I believe the only true fix to this issue is to de-solder the the flash, reprogram it, and solder it back in place.

If the flash security section is locked, then yes- that's the only solution that I'm aware of. Patching the software tool chain is way way way easier though, so unless you are really fond of working on boards I don't recommend replacing the flash.

drujensen, 2023-09-15:
https://github.com/tinyfpga/TinyFPGA-Bootloader/pull/73

jeffpc, 2023-09-29:
I don't know anywhere near enough about USB, but it sounds like there are possibly different levels of problems with the latest batch of BX boards.  (I got one via Mouser.)  Mine, for example, fails to complete the USB initialization with the host, and so the host doesn't even get far enough to present a usable device for tinyprog to use.

I filed a bug about it:
https://github.com/tinyfpga/TinyFPGA-Bootloader/issues/74

richgel999, 2023-10-15:
I'm getting the "No metadata" error too. Bummed out.

richgel999, 2023-10-15:
> Should hack a solution in this driver to handle the broken boards?
>
> Maybe something like: if the query to the metadata fails, use this default json file.

Yes, please. I'm a FPGA beginner, and it looks like I can't use this TinyFPGA BX board without hacking some source files. Thanks!

richgel999, 2023-10-16:
Even after getting my TinyFPGA BX from Crowd Supply to program (by working around the no metadata bug), I noticed the 3v3 pin is actually 5v. This explains why the LED's are so insanely bright. The 3v3 regulator is not functional.

If I can't even program it out of the box without hacking the programming software, something is wrong. How was this ever shipped?

psychogenic, 2023-12-12:
This is great, Aarón: just tried your patch, and it worked: thanks!  I patched it a bit further (PR issued--I wanted to be able to use all my BX using the same commands, so the -atb can be dropped once the fix is applied to a board).

aacuevas, 2023-12-14:
Cool! This is a nice patch, as at least normal operation can be done as normally.

I think some automation should still be possible to tell chips apart and not require the --atb flag at all. It's annoying that they did not update the DeviceID command, which is for this case specifically. Bur probably the SFPD records can be used for this, even if it's in a very naïve and hacky way,

jonathancollins514, 2024-01-03:
hi @aacuevas ,

THanks for all of this,  is there a place to download the final exe of the programmer?  Can you also elaborate more on the LDO issue making the led blinding and if it can also be fixed.

eyz, 2024-04-02:
Did anyone get a board without this issue? If so, when did you order it, and when did you receive it?

AaronJackson, 2024-04-02:
> Did anyone get a board without this issue? If so, when did you order it, and when did you receive it?

I've also got this issue - came through in the latest Crowdsupply batch, received a week or two ago. Tried emailing tinyfpga but not heard anything back.

maydaym3, 2024-04-23:
Received two BX boards from Mouser late August 2023 and just now getting to them, both have no metadata issue

eyz, 2024-04-23:
> Received two BX boards from Mouser late August 2023 and just now getting to them, both have no metadata issue

That's great news. Also, can you confirm the voltage on the 3.3 volt and 5 volt rails? I think that was the only other concern. Additionally, if you have any markings from the metadata or physically please let us know the batch numbers or whatever you can applicable from your builds.

maydaym3, 2024-04-23:
> > Received two BX boards from Mouser late August 2023 and just now getting to them, both have no metadata issue
>
> That's great news. Also, can you confirm the voltage on the 3.3 volt and 5 volt rails? I think that was the only other concern. Additionally, if you have any markings from the metadata or physically please let us know the batch numbers or whatever you can applicable from your builds.

sorry 'No Metadata' issue
`    TinyProg CLI
    ------------
    Using device id 1d50:6130
    Only one board with active bootloader, using it.
    Boards with active bootloaders:

        /dev/ttyACM1: No metadata
`

arndgo, 2024-05-02:
Hi Aarón, thanks a lot for figuring that out. Your solution is working perfectly.
To be honest, it was hard for me, to get a running tinyprog.exe program out of the code. This is mostly related to my missing knowledge about Python and the tool chain. But finally I made it.
One small thing about your changes. At line 333 you added:
 print("Can't find meta--attempting Adesto B patch")
That's nice for information, but if you are using e.g. Icestudio, this 'information' is an issue for the FPGA tool chain. Not a big deal, as you can program the FPGA manual via command line.
For test reason, I out-commented this line, and the programming out of Icestudio is also possible without any issues.

I'm a little bit disappointed about Crowd Supply, that there is no patch or notice about the issue(s) with some of the modules...
It's 8 month now, and no official reaction :-(

Many thanks again Aarón for your patch. Perfect work....

taylor-hartman, 2024-05-07:
@AaronJackson Just ran into this issue as well, but unfortunately i seem to not be able to get to work with your fork/hack.

I'm getting:

`TypeError: ord() expected a character, but string of length 0 found`

Whenever I try to write security page 3, or a .bin.

Any guidance is much appreciated.

AaronJackson, 2024-05-07:
@taylor-hartman there are two Aarons in this thread, think you mean @aacuevas

I am useless and a newb and gave up as soon as I ran into the issue. Maybe I'll try again eventually but so far it was a waste of $60 :sob:

scm2000, 2024-05-07:
> @taylor-hartman there are two Aarons in this thread, think you mean @aacuevas
>
> I am useless and a newb and gave up as soon as I ran into the issue. Maybe I'll try again eventually but so far it was a waste of $60 😭

I'll withhold my opinion of this situation and just say if you follow this thread carefully, you will have a good chance of getting your board working. If not it's a 60 dollar lesson you've learned.

eyz, 2024-05-09:
Sure feels like we're on our own. Who's going to fork this and fix the remaining issues?

Bexin3, 2024-07-03:
Unable to upload here too, system report doesn't see the board, quite disappointing there was never a statement on this and crowdsource keeps selling them

maydaym3, 2024-07-04:
i am currently working on a pi pico uf2 that will be able to reprog the spi flash. to be able to be recognized by tinyprog. it will require either a soic8 programmer clip or some minor soldering to work. more to come in the next week/month.

also, my boards came with the 5v0 LDO instead of the 3V3.... SMH. i dont even want to see what the EX board is going to be like...

Bexin3, 2024-07-04:
> i am currently working on a pi pico uf2 that will be able to reprog the spi flash. to be able to be recognized by tinyprog. it will require either a soic8 programmer clip or some minor soldering to work. more to come in the next week/month.
>
> also, my boards came with the 5v0 LDO instead of the 3V3.... SMH. i dont even want to see what the EX board is going to be like...

Quite unfortunate, to be honest I am tempted to just returning this and trying the new batch as it seems like a solid bit of effort. But then who knows if the new batch will be any better

Bexin3, 2024-07-21:
I have now tried this in windows and the errors are different though I am confused about the cause

`PS C:\Users\Bexin\Downloads\tinyfpga\tinyfpga> tinyprog -p test-tiny.bin

    TinyProg CLI
    ------------
    Using device id 1d50:6130
    Only one board with active bootloader, using it.
    Programming COM4 with test-tiny.bin
Traceback (most recent call last):
  File "<frozen runpy>", line 198, in _run_module_as_main
  File "<frozen runpy>", line 88, in _run_code
  File "C:\Users\Bexin\AppData\Local\Programs\Python\Python312\Scripts\tinyprog.exe\__main__.py", line 7, in <module>
  File "C:\Users\Bexin\AppData\Local\Programs\Python\Python312\Lib\site-packages\tinyprog\__main__.py", line 334, in main
    addr = fpga.meta.userimage_addr_range()[0]
           ^^^^^^^^^^^^^^^^^^^^^^^^^^^^^^^^
  File "C:\Users\Bexin\AppData\Local\Programs\Python\Python312\Lib\site-packages\tinyprog\__init__.py", line 182, in userimage_addr_range
    return self._get_addr_range(u"userimage")
           ^^^^^^^^^^^^^^^^^^^^^^^^^^^^^^^^^^
  File "C:\Users\Bexin\AppData\Local\Programs\Python\Python312\Lib\site-packages\tinyprog\__init__.py", line 188, in _get_addr_range
    addr_str = self.root[u"bootmeta"][u"addrmap"][name]
               ~~~~~~~~~^^^^^^^^^^^^^
TypeError: 'NoneType' object is not subscriptable`

eyz, 2024-07-22:
Would anyone be up for a full PCBA project export for these, with zero programming? I think we need to take this over, because there have been no updates from the original project owner on this for some time

eyz, 2024-10-01:
Let's try to ensure the next round of boards won't have 5V on the 3.3V pin (https://github.com/tinyfpga/TinyFPGA-BX/issues/39#issuecomment-2386551707) due to a `AP2210K-3.3` part swap having pin 4 wired, and hasn't written zeros to the area of the PROM on the FPGA where metadata needs to exist to allow `tinyprog` to identify the board (https://github.com/tinyfpga/TinyFPGA-BX/issues/37#issuecomment-1694056732).

Per Mouser, there is a batch expected out around May 2025. If these are also botched, let's try and get PCBA files to produce these instead.

If anyone has a contact for who is producing the next run, could you please out to them and let them know of these two critical issues? A Mouser contact here who is on Github would also be appreciated to share the findings.

Bexin3, 2024-10-01:
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

I believe the flash overwriting thing only happened to some people, as it worked for me after cutting off the extra pin to make it 3.3v, as well as some others, so it's worth trying.
That said I really hope the same issue won't be on the next batch, definitely needs to get looked into.

eyz, 2024-10-01:
> I believe the flash overwriting thing only happened to some people, as it worked for me after cutting off the extra pin to make it 3.3v, as well as some others, so it's worth trying. That said I really hope the same issue won't be on the next batch, definitely needs to get looked into.

Odd. So, the metadata is stored in an area of the FPGA that can only be written once. It makes me wonder if some of the boards that had the 5V issue also possibly didn't overwrite that area with zeros. It's quite clearly a single-time program, locking in after then. I'd love some other theories about how these two could correlate.

eyz, 2024-10-01:
> I believe the flash overwriting thing only happened to some people, as it worked for me after cutting off the extra pin to make it 3.3v, as well as some others, so it's worth trying. That said I really hope the same issue won't be on the next batch, definitely needs to get looked into.

Maybe these were two different events, with some of the 5V on 3.3V pin boards also having been one-time programmed with incorrect metadata; perhaps there were multiple production runs with different conditions. Thanks for the insight

cloudxcc, 2024-12-11:
Ola @aacuevas,
Thanks a lot for your fix. Sorry for this pathetic question, but how do I install your branch using either pip or starting from a local copy. I' using cygwin and the original tinyprog "pip" installation worked, but the metadata issue came up. Hope your fix will help once O get the branch working.
Thanks a lot in advance.

Thread 38 (2023-09-14):

Can the default power on state be changed?

scm2000, 2023-09-14:
I just got my TinyFPGA-BX, along with it not having metadata installed on it -- which I worked around--   it looks like the default power on state is to sit in the boot loader waiting for programming.   Is there a way to change things so that by default it just runs the code I already programmed in to it upon power up?
For information, I'm connecting it to an M1 Macbook Pro, with a micro-usb to usb-c cable for power and programming.

scm2000, 2023-09-14:
Ok I solved it... sorry ...    If you plug it into a mac usb port it does start off by sitting in the boot loader.    If you plug it into a dumb USB power supply it starts up running the user code.

Closed 2023-09-14.

Thread 39 (2023-10-16):

3v3 pin is 5v on a BX from Crowd Supply

richgel999, 2023-10-16:
I first had to work around the "no metadata" issue (by modifying a python file, as others describe). I'm now able to program the FPGA using the default template and I see the boot LED blink "SOS".

I noticed that LED's are extremely (too) bright, which is odd. They've always been this way since when I first plugged it in.

I measured the 3.3v pin (pin #25), and it's measuring 5v when plugged into USB. If I unplug USB and supply 4.5v to the "in" pin, I get 4.5v at the 3.3v pin. The 3.3v regular doesn't appear to be working.

I'm at a loss at what to do now. Perhaps try another platform.

jeffpc, 2023-10-21:
I've gotten two BX boards from Mouser recently and they both fail to finish the USB handshake (https://github.com/tinyfpga/TinyFPGA-Bootloader/issues/74). Additionally, they both have 5V on the 3.3V rail.  There are *no* shorts between the two rails; the 1.2V rail is spot on.  So, I also suspect that the MIC5504-3.3YM5 voltage regulator is bad.

leaningktower, 2023-11-24:
Hi jeffpc, I found the same issue as you mentioned recently and I also can not find a short. I found this problem because I want to use an external clock input and it turns out I need at least 5 V to make the it work and it turns out the 3.3 V is totally wrong.
After simple testing, I am also pretty sure the LDO is not broken but it is a different LDO rather than the MIC5501 in the schematic. The code on the 3.3 V LDO is g5k, and it turns out to be AP2210K-3.3. However, the pin 4 of this LDO is not NC pin and can not be connected together with the VOUT pin 5. And that is why the LDO gives an saturated output that looks like a short. The simple solution I did is cut the pin 4 and 3.3 V is back.

jeffpc, 2023-11-25:
Good catch! Both of my boards have a 3.3V regulators marked G5K.  I cut pin 4 on one and now the 3.3V rail is 3.3V like it should be. Sadly, this didn't fix my other problem (USB handshake).

leaningktower, 2023-11-26:
I purchased my board throw crowd supply and wait it for at least 6 months. Unfortunately I mistakenly broken the FPGA today, instead of waiting for the crazy lead time, I decided to purchase several iCE40LP8K chips and BGA soldering tools.

jonathancollins514, 2024-01-03:
datasheet:
https://www.diodes.com/assets/Datasheets/AP2210.pdf

pin4:
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

arndgo, 2024-05-02:
Thanks, works. Getting 3.3V now.
Great work.

eyz, 2024-10-01:
> I cut pin 4 on one and now the 3.3V rail is 3.3V like it should be.

@jeffpc What did you do? I can't tell exactly from the picture. Did you simply snip off pin 4 at the AP2210? Do you know why that works?

eyz, 2024-10-01:
I snipped pin 4 with an angle cutter on the G5K 3.3v regulator, and confirmed that the whole lead down to the PCB was removed successfully. Getting 3.3v, as others have stated here -
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

The angle of the camera doesn't show the cut due to the angle; the G5K and PCB are quite separate in height, and nowhere near connected now -
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

eyz, 2024-10-01:
I see there's another round of boards due out ~ May 2025. I hope they fix this, and don't ruin the one-time PROM metadata flash area this time. It would be nice to not have another broken round of boards one year out.

Thread 40 (2024-04-07):

tinypga.com unusable

pm100, 2024-04-07:
It redirects to guide.html which redirects to guide.html.....

ladyada, 2024-04-15:
pinging @lukevalenty in case they dont subscribe

eyz, 2024-05-09:
> pinging @lukevalenty in case they dont subscribe

It's a good try, but I'm pretty sure he's checked out now. Also see https://github.com/tinyfpga/TinyFPGA-BX/issues/37

eyz, 2024-10-01:
Also, let's hope the next round of boards doesn't have 5V on the 3.3V pin, and hasn't wiped the PROM on the FPGA where metadata needs to exist to allow `tinyprog` to function. Per Mouser, there is a batch expected out around May 2025. If these are also botched, let's try and get PCBA files to produce these.

ladyada, 2024-10-02:
this project seems abandoned, we dont stock the tinyfpga anymore. you can try contacting crowdsupply @helenleigh
