tinyfpga/TinyFPGA-BX/board/TinyFPGA-BX-Schematic.pdf

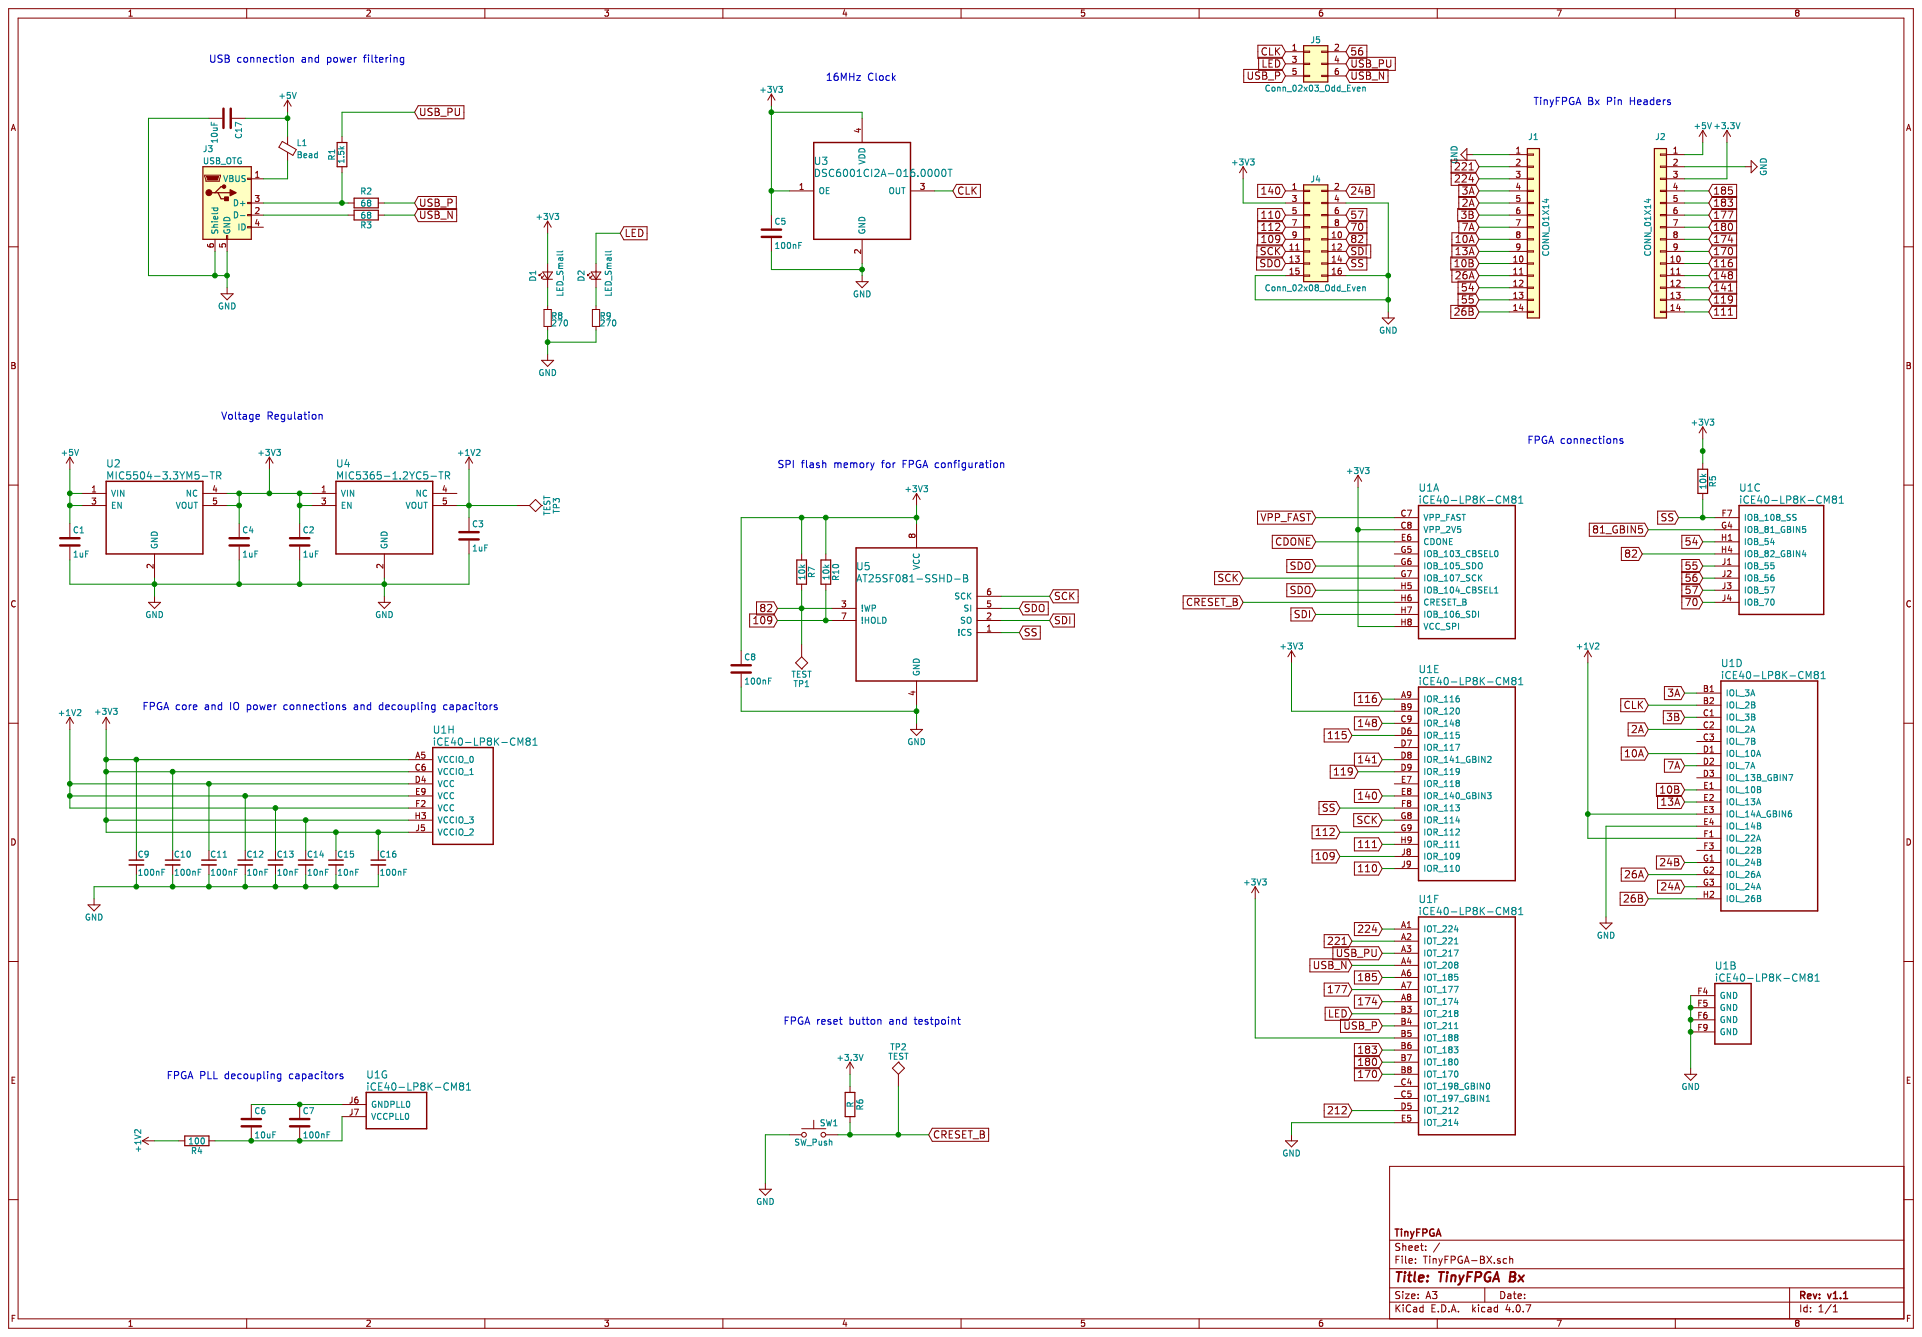
[picture p3: page 1]
