tinyfpga/TinyFPGA-BX/board/TinyFPGA-BX.kicad_pcb

## KiCad design board/TinyFPGA-BX.kicad_pcb (2018-03-30)

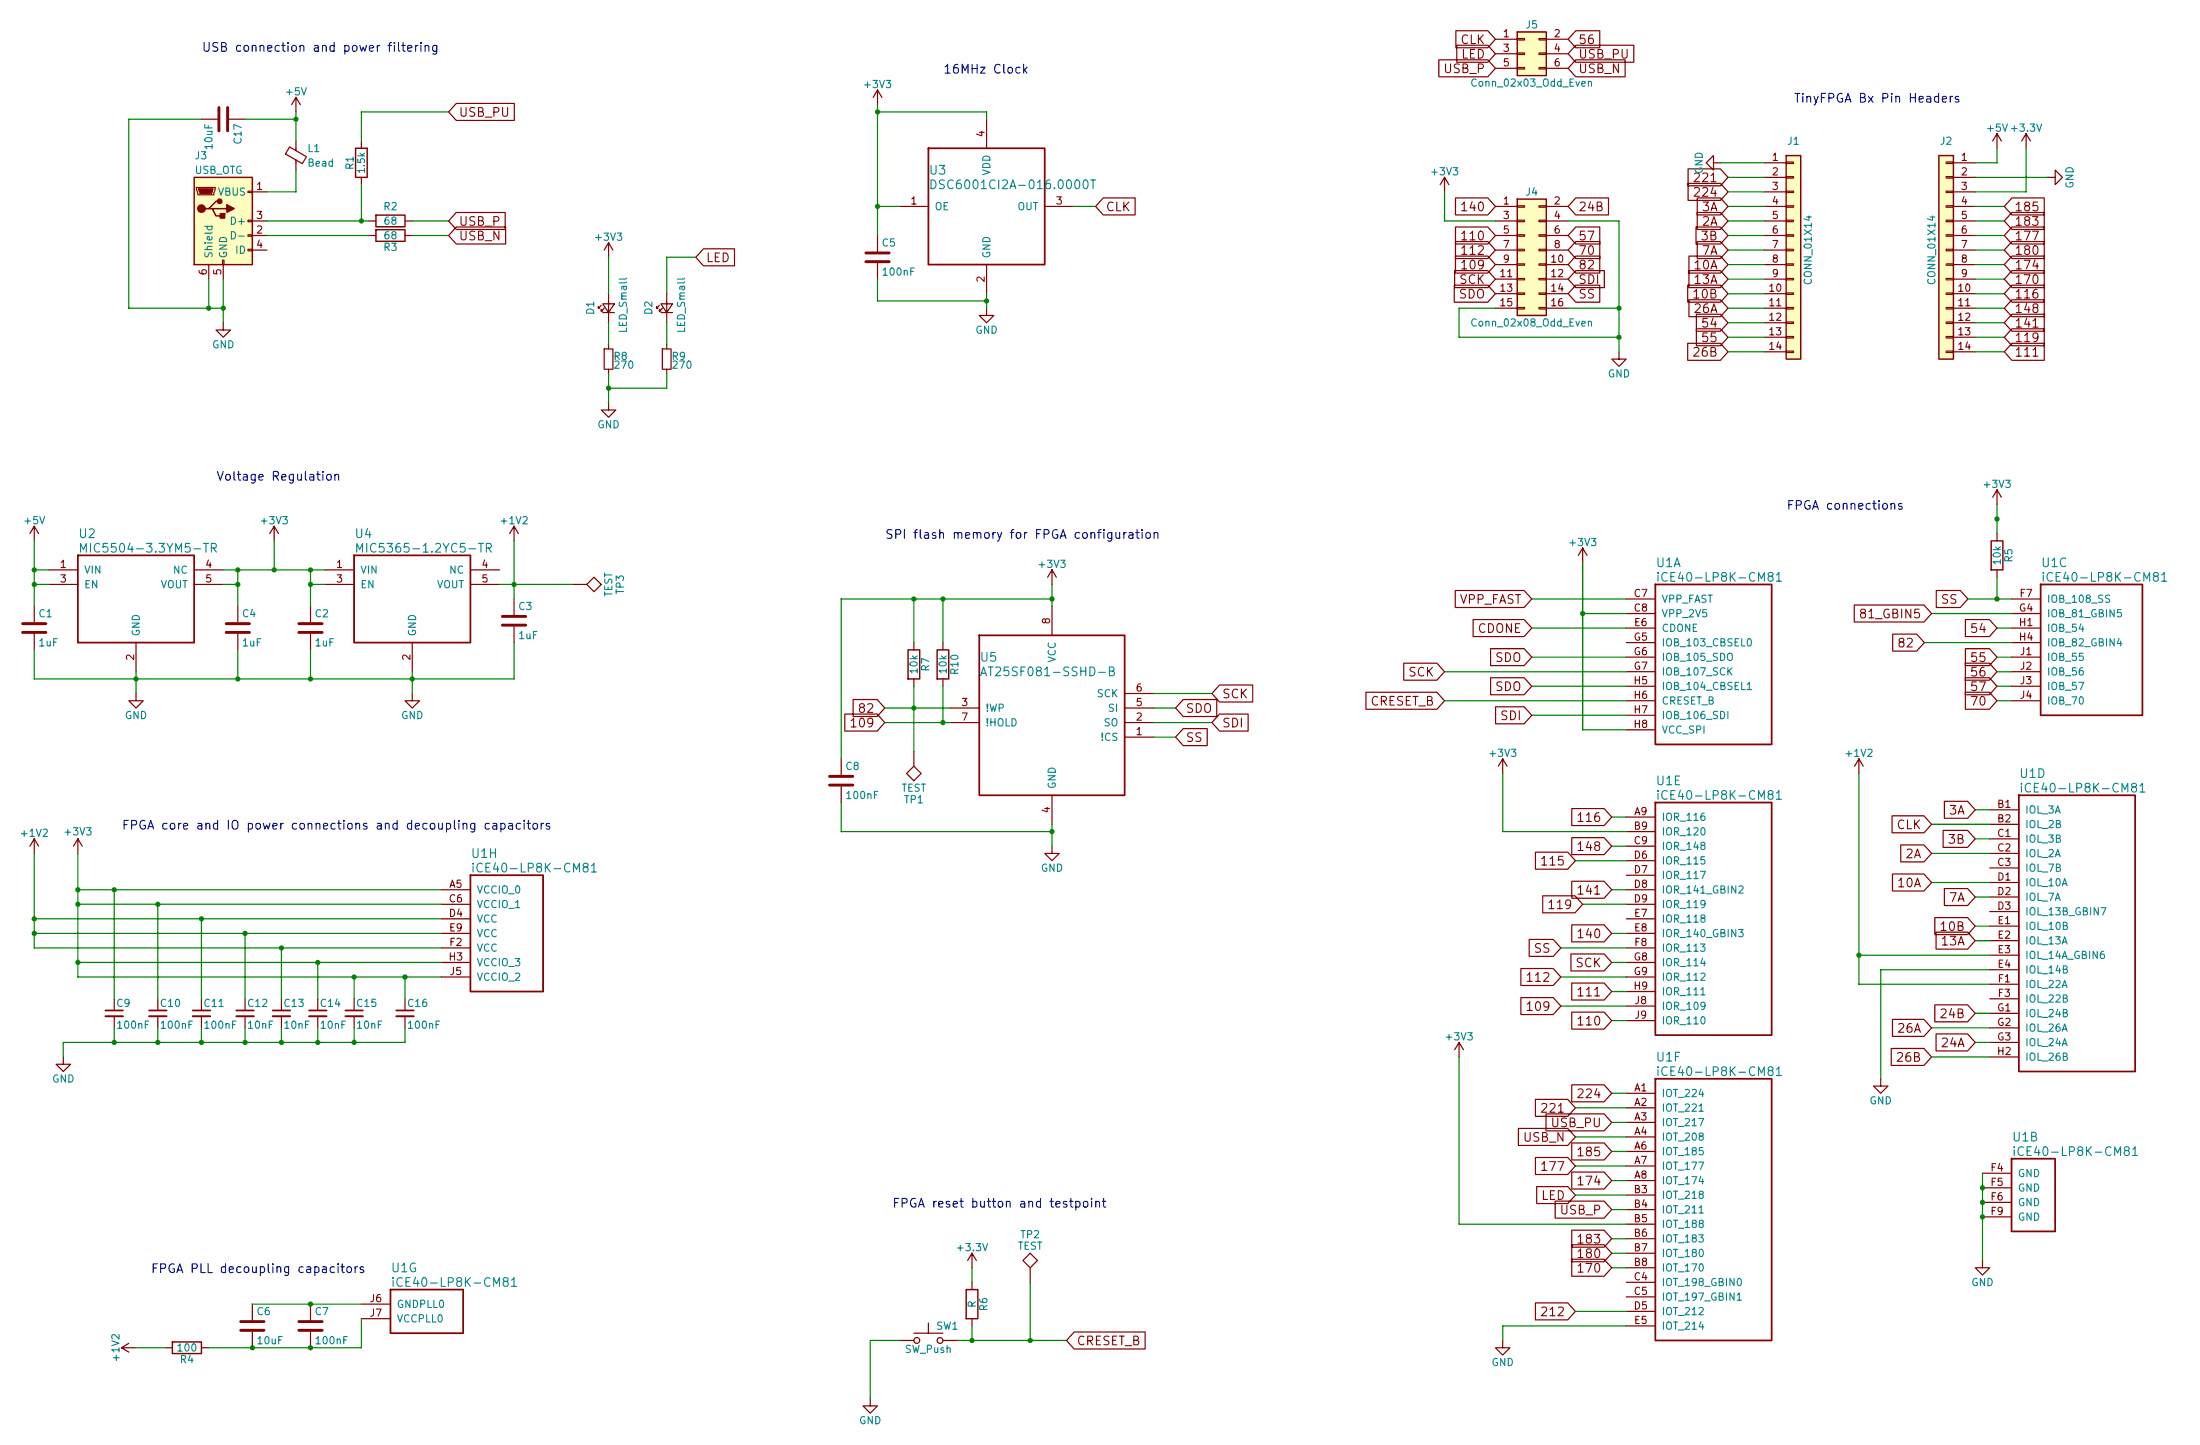
[picture p4: schematic TinyFPGA-BX.sch, TinyFPGA Bx]

Parts:
C1, C2, C3, C4: 1uF; C_0402_NoSilk
C5, C7, C8, C9, C10, C11, C16: 100nF; C_0402_NoSilk
C6, C17: 10uF; C_0603
C12, C13, C14, C15: 10nF; C_0402_NoSilk
D1, D2: LED_Small; LED_0603
J1, J2: CONN_01X14; Pin_Header_Straight_1x14_Pitch2.54mm
J3: USB_OTG; USB_Micro-B
J4: Conn_02x08_Odd_Even; Pin_Header_Straight_2x08_Pitch2.54mm_SMD
J5: Conn_02x03_Odd_Even; Pin_Header_Straight_2x03_Pitch2.54mm_SMD
L1: Bead; L_0603
R1: 1.5k; R_0402_NoSilk
R2, R3: 68; R_0402_NoSilk
R4: 100; R_0402_NoSilk
R5, R7, R10: 10k; R_0402_NoSilk
R6: R; R_0402
R8, R9: 270; R_0402_NoSilk
SW1: SW_Push; PTS_810_SMT_Switch
TP1, TP2, TP3: TEST; Measurement_Point_Round-SMD-Pad_Small
U1: iCE40-LP8K-CM81; CM81
U2: MIC5504-3.3YM5-TR; SC-70-C5
U3: DSC6001CI2A-016.0000T; CDFN3225-4LD-PL-1
U4: MIC5365-1.2YC5-TR; SC-70-C5
U5: AT25SF081-SSHD-B; SOIC-8-1EP_3.9x4.9mm_Pitch1.27mm

Connections:
2A: J1.5, U1.C2 (IOL_2A)
3A: J1.4, U1.B1 (IOL_3A)
3B: J1.6, U1.C1 (IOL_3B)
7A: J1.7, U1.D2 (IOL_7A)
10A: J1.8, U1.D1 (IOL_10A)
10B: J1.10, U1.E1 (IOL_10B)
13A: J1.9, U1.E2 (IOL_13A)
24A: U1.G3 (IOL_24A)
24B: J4.2, U1.G1 (IOL_24B)
26A: J1.11, U1.G2 (IOL_26A)
26B: J1.14, U1.H2 (IOL_26B)
54: J1.12, U1.H1 (IOB_54)
55: J1.13, U1.J1 (IOB_55)
56: J5.2, U1.J2 (IOB_56)
57: J4.6, U1.J3 (IOB_57)
70: J4.8, U1.J4 (IOB_70)
81_GBIN5: U1.G4 (IOB_81_GBIN5)
82: J4.10, R7.2, TP1.1, U1.H4 (IOB_82_GBIN4), U5.3 (!WP)
109: J4.9, R10.2, U1.J8 (IOR_109), U5.7 (!HOLD)
110: J4.5, U1.J9 (IOR_110)
111: J2.14, U1.H9 (IOR_111)
112: J4.7, U1.G9 (IOR_112)
115: U1.D6 (IOR_115)
116: J2.10, U1.A9 (IOR_116)
119: J2.13, U1.D9 (IOR_119)
140: J4.1, U1.E8 (IOR_140_GBIN3)
141: J2.12, U1.D8 (IOR_141_GBIN2)
148: J2.11, U1.C9 (IOR_148)
170: J2.9, U1.B8 (IOT_170)
174: J2.8, U1.A8 (IOT_174)
177: J2.6, U1.A7 (IOT_177)
180: J2.7, U1.B7 (IOT_180)
183: J2.5, U1.B6 (IOT_183)
185: J2.4, U1.A6 (IOT_185)
212: U1.D5 (IOT_212)
221: J1.2, U1.A2 (IOT_221)
224: J1.3, U1.A1 (IOT_224)
+1V2: C3.1, C11.1, C12.1, C13.1, R4.2, TP3.1, U1.D4 (VCC), U1.E3 (IOL_14A_GBIN6), U1.E9 (VCC), U1.F1 (IOL_22A), U1.F2 (VCC), U4.5 (VOUT)
+5V: C1.1, C17.1, J2.1, L1.1, U2.1 (VIN), U2.3 (EN)
CDONE: U1.E6 (CDONE)
CLK: J5.1, U1.B2 (IOL_2B), U3.3 (OUT)
CRESET_B: R6.2, SW1.2, TP2.1, U1.H6 (CRESET_B)
GND: C1.2, C2.2, C3.2, C4.2, C5.2, C8.2, C9.2, C10.2, C11.2, C12.2, C13.2, C14.2, C15.2, C16.2, C17.2, J1.1, J2.2, J3.5 (GND), J3.6 (Shield), J4.4, J4.15, J4.16, R8.2, R9.2, SW1.1, U1.E4 (IOL_14B), U1.E5 (IOT_214), U1.F4 (GND), U1.F5 (GND), U1.F6 (GND), U1.F9 (GND), U2.2 (GND), U3.2 (GND), U4.2 (GND), U5.4 (GND)
LED: D2.2 (A), J5.3, U1.B3 (IOT_218)
unnamed: C6.1, C7.1, U1.J6 (GNDPLL0)
unnamed: C6.2, C7.2, R4.1, U1.J7 (VCCPLL0)
unnamed: D1.1 (K), R8.1
unnamed: D2.1 (K), R9.1
unnamed: J3.1 (VBUS), L1.2
unnamed: J3.2 (D-), R3.2
unnamed: J3.3 (D+), R1.1, R2.2
SCK: J4.11, U1.G7 (IOB_107_SCK), U1.G8 (IOR_114), U5.6 (SCK)
SDI: J4.12, U1.H7 (IOB_106_SDI), U5.2 (SO)
SDO: J4.13, U1.G6 (IOB_105_SDO), U1.H5 (IOB_104_CBSEL1), U5.5 (SI)
SS: J4.14, R5.2, U1.F7 (IOB_108_SS), U1.F8 (IOR_113), U5.1 (!CS)
USB_N: J5.6, R3.1, U1.A4 (IOT_208)
USB_P: J5.5, R2.1, U1.B4 (IOT_211)
USB_PU: J5.4, R1.2, U1.A3 (IOT_217)
VPP_FAST: U1.C7 (VPP_FAST)

Notes on the sheet:
FPGA core and IO power connections and decoupling capacitors
FPGA PLL decoupling capacitors
USB connection and power filtering
Voltage Regulation
16MHz Clock
SPI flash memory for FPGA configuration
FPGA reset button and testpoint
FPGA connections
TinyFPGA Bx Pin Headers

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
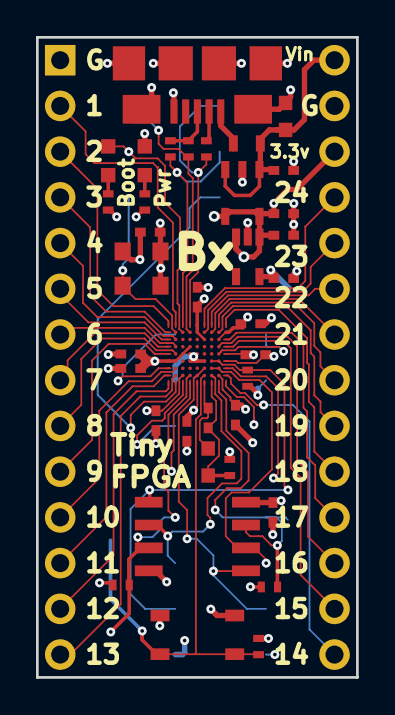
[picture p5: board TinyFPGA-BX.kicad_pcb from above]

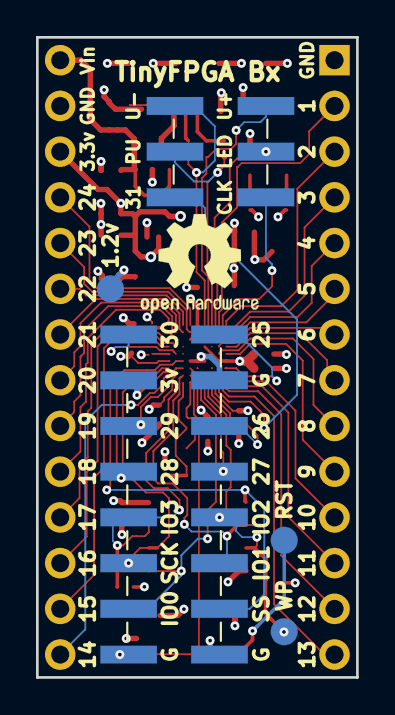
[picture p6: board TinyFPGA-BX.kicad_pcb from below]

Board: 4 copper layers, 17.8 x 35.6 mm, 44 parts (5 on the bottom side), 54 nets.
