tinyfpga/TinyFPGA-BX/(commit log)

2018-03-30 first TinyFPGA BX commit after forking from B-series
    [TinyFPGA-BX.kicad_pcb, TinyFPGA-BX.sch]
2018-07-23 add picosoc example with simple GPIO LED
